abtriz/sentry/docs/esboço_tecnico.png

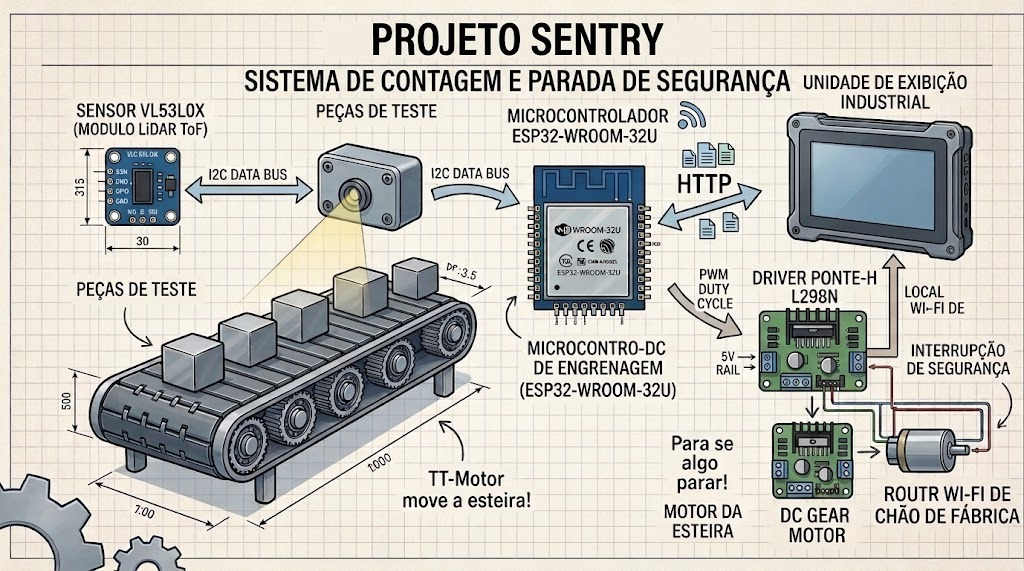
docs/esboço_tecnico.png
