abtriz/sentry/(commit log)

2026-11-07 Adiciona .gitignore para credenciais e arquivos gerados
2026-11-07 feat(esp32): leitura do VL53L0X, contagem de peças e parada de segurança
2026-11-07 feat(esp32): salva a contagem na memória flash
    Removed setup and loop functions from esteira.h.
2026-11-07 test: adiciona teste individual do sensor laser VL53L0X
2026-11-07 test: adiciona teste individual do módulo relé 5V
2026-11-07 Create app.js: integração do Painel à API do ESP32
2026-11-07 Add ESP32 HTTP server implementation
2026-11-07 Add API test script for ESP32 interactions
